andrewsuggs465/esp32-c3/esp32/esp32.kicad_pcb

## KiCad design esp32/esp32.kicad_pcb (2026-10-19)

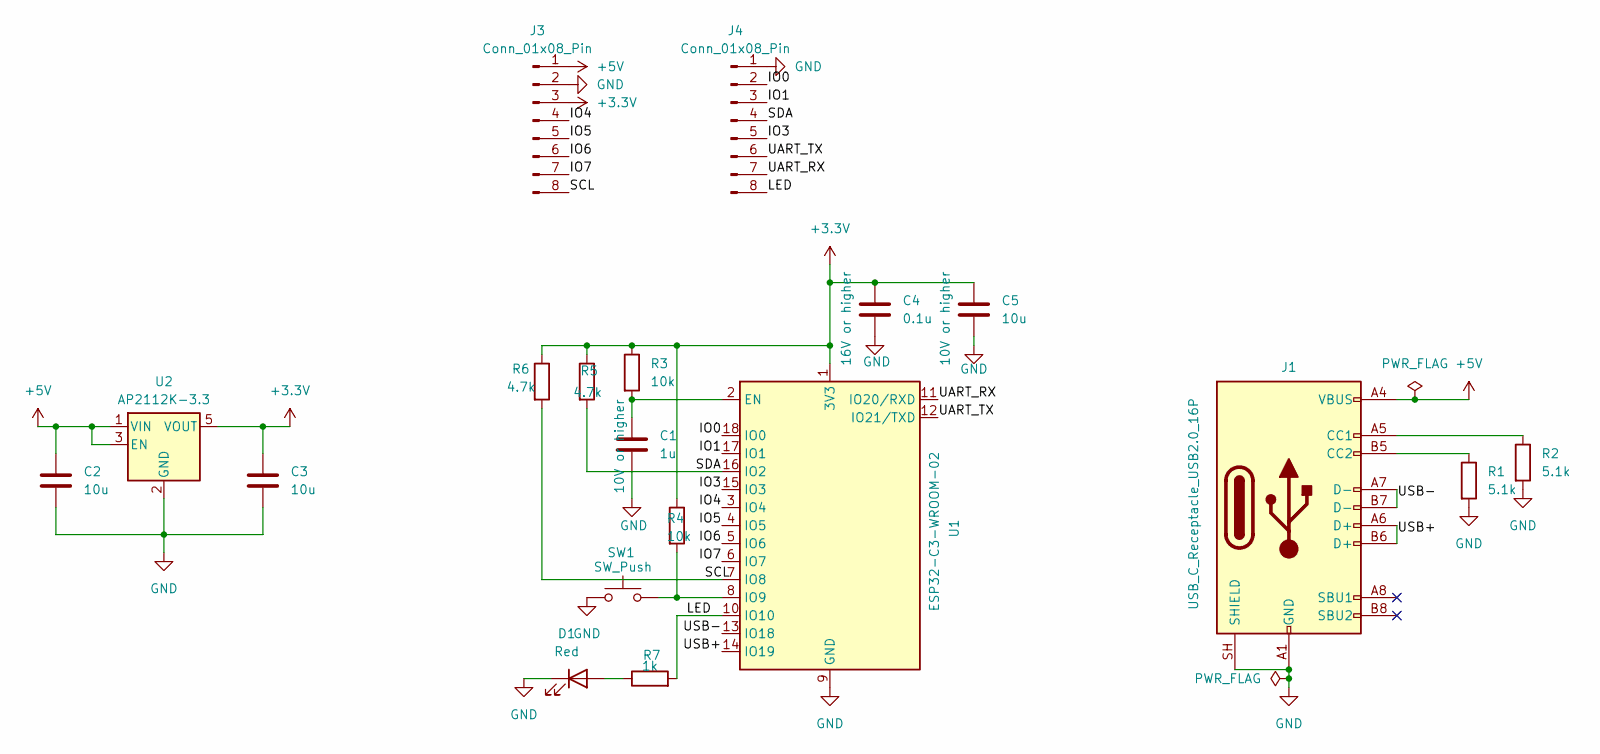
[picture p1: schematic esp32.kicad_sch]

Parts:
C1: 1u; C_0603_1608Metric
C2, C3, C5: 10u; C_0603_1608Metric
C4: 0.1u; C_0603_1608Metric
D1: Red; LED_0603_1608Metric
J1: USB_C_Receptacle_USB2.0_16P; USB_C_Receptacle_HRO_TYPE-C-31-M-12
J3, J4: Conn_01x08_Pin; PinHeader_1x08_P2.54mm_Vertical
R1, R2: 5.1k; R_0603_1608Metric
R3, R4: 10k; R_0603_1608Metric
R5, R6: 4.7k; R_0603_1608Metric
R7: 1k; R_0603_1608Metric
SW1: SW_Push; SW_SPST_PTS810
U1: ESP32-C3-WROOM-02
U2: AP2112K-3.3; SOT-23-5

Connections:
+3.3V: C3.1, C4.1, C5.1, J3.3, R3.1, R4.1, R5.1, R6.1, U1.1 (3V3), U2.5 (VOUT)
+5V: C2.1, J1.A4 (VBUS), J1.A9 (VBUS), J1.B4 (VBUS), J1.B9 (VBUS), J3.1, U2.1 (VIN), U2.3 (EN)
/IO0: J4.2, U1.18 (IO0)
/IO1: J4.3, U1.17 (IO1)
/IO3: J4.5, U1.15 (IO3)
/IO4: J3.4, U1.3 (IO4)
/IO5: J3.5, U1.4 (IO5)
/IO6: J3.6, U1.5 (IO6)
/IO7: J3.7, U1.6 (IO7)
/LED: J4.8, R7.2, U1.10 (IO10)
/SCL: J3.8, R6.2, U1.7 (IO8)
/SDA: J4.4, R5.2, U1.16 (IO2)
/UART_RX: J4.7, U1.11 (IO20/RXD)
/UART_TX: J4.6, U1.12 (IO21/TXD)
/USB+: J1.A6 (D+), J1.B6 (D+), U1.14 (IO19)
/USB-: J1.A7 (D-), J1.B7 (D-), U1.13 (IO18)
GND: C1.2, C2.2, C3.2, C4.2, C5.2, D1.1 (K), J1.A1 (GND), J1.A12 (GND), J1.B1 (GND), J1.B12 (GND), J1.SH (SHIELD), J3.2, J4.1, R1.2, R2.2, SW1.1, U1.9 (GND), U1.19 (GND), U2.2 (GND)
unnamed: D1.2 (A), R7.1
unnamed: J1.A5 (CC1), R2.1
unnamed: J1.B5 (CC2), R1.1
unnamed: C1.1, R3.2, U1.2 (EN)
unnamed: R4.2, SW1.2, U1.8 (IO9)

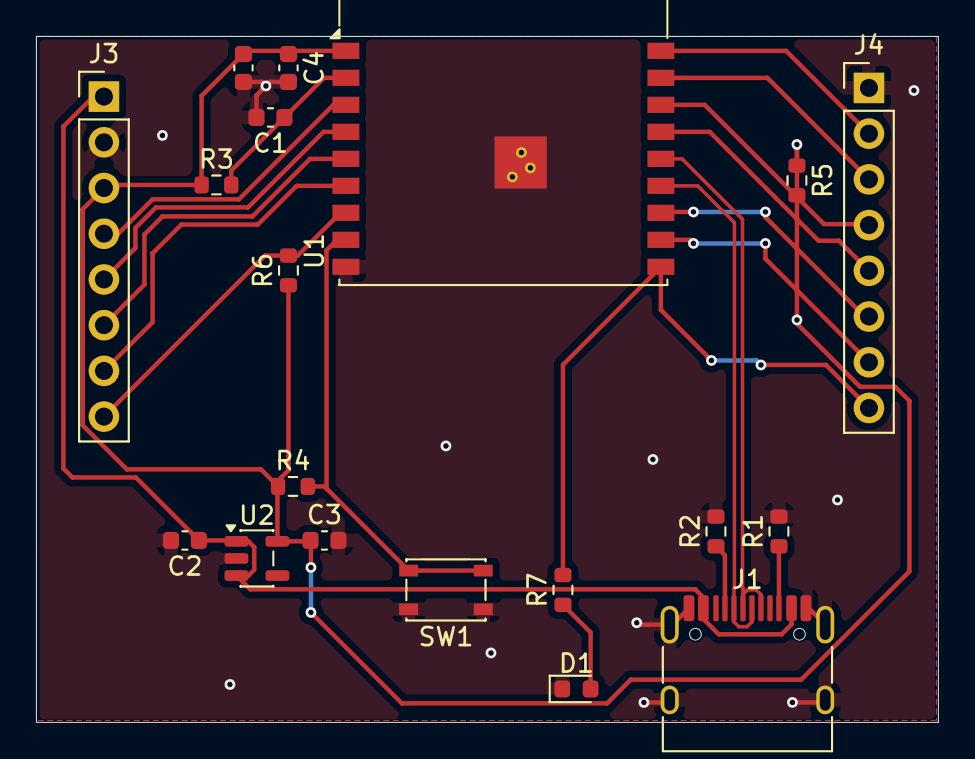
[picture p2: board esp32.kicad_pcb from above]

Board: 2 copper layers, 50.1 x 38.1 mm, 19 parts (0 on the bottom side), 22 nets.
