andrewsuggs465/esp32-c3/tutorial/figures/screenshot001.png

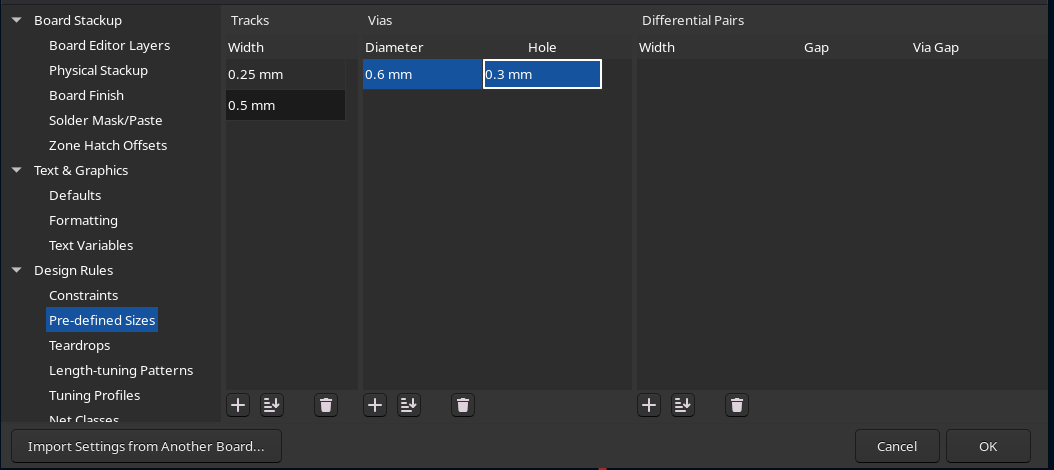
tutorial/figures/screenshot001.png
